cbarnhardt/SolarHarvestGPS/SolarHarvestGPS/20210426_162232.jpg

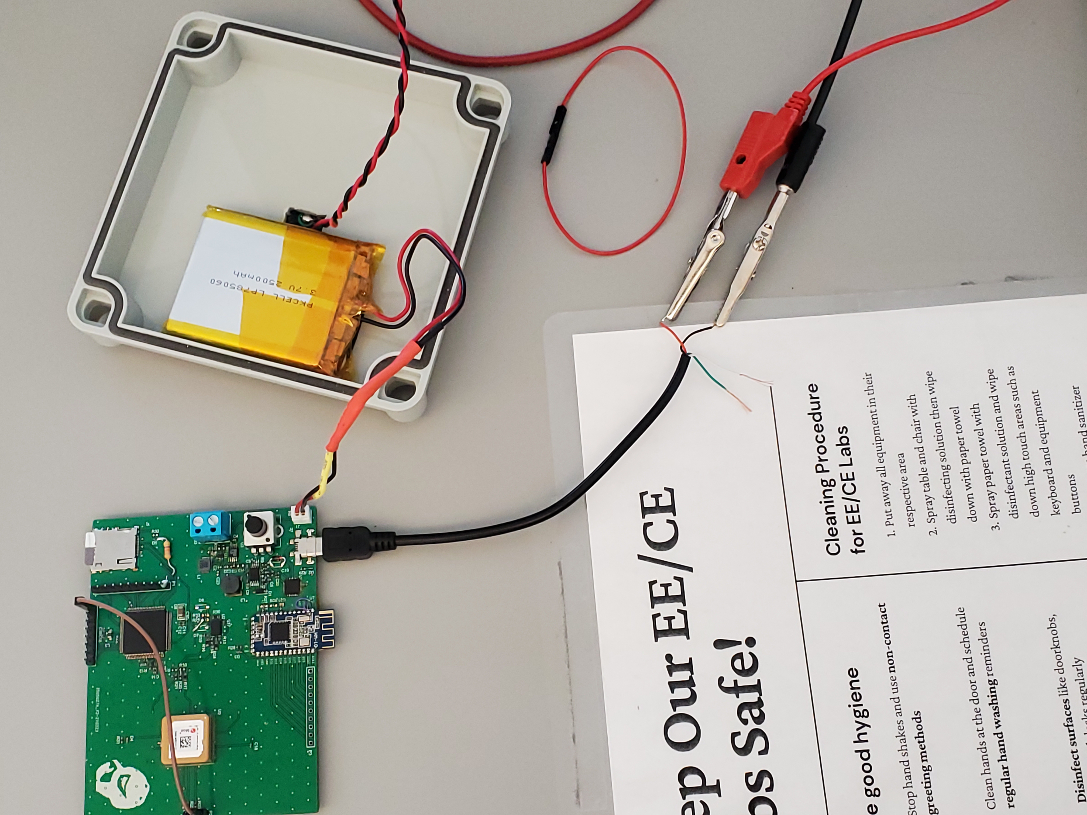
SolarHarvestGPS/20210426_162232.jpg
