cbarnhardt/SolarHarvestGPS/SolarHarvestGPS/20210426_161814.jpg

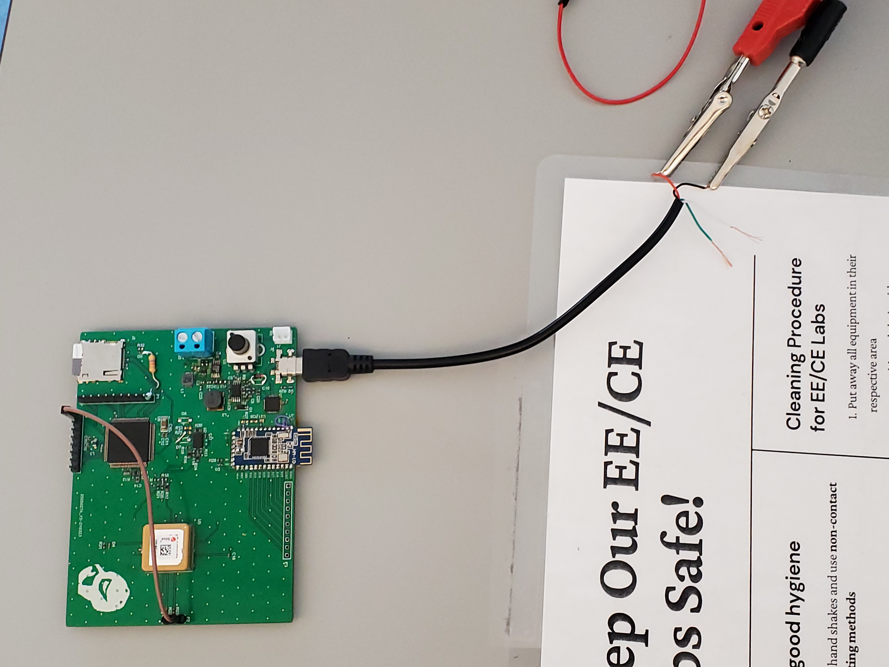
SolarHarvestGPS/20210426_161814.jpg
