cbarnhardt/SolarHarvestGPS/README.md

# SolarHarvestGPS
Project for embedded systems design course
Includes code and Altium files for the project. There is a portion of the report included to 
clarify what the project is and explain what it does. The devices used were a TI-MSP432 and
a SAM-M8Q along with various other peripherals.
