cbarnhardt/SolarHarvestGPS/SolarHarvestGPS/GPSBoardSourceFiles/GPS_Tracker_Logger.xls

Designator | Description | Value | Manufacturer | Manufacturer P/N | Vendor | Vendor P/N | Price | Quantity
BT1 | Adafruit Accessories Lithium Ion Polymer Battery 3.7V 2500mAh | - | Adafruit | 328 | Mouser | 485-328 | $14.95 | 0
C1 | Capacitor X6S 0402 (1005 Metric) | 22uF | Samsung Electro-Mechanics | GRM155R60J106ME05J | Mouser | 187-CL05A226MQ5N6J8 | $0.52 | 1
C2, C3, C4, C5, C6, C7, C22, C23 | Capacitor X6S 0402 (1005 Metric) | 10uF | Murata Electronics | GRM155R60J106ME05J | Mouser | 81-GRM155R60J106ME05 | $0.15 | 8
C8, C18, C20 | Capacitor X6S 0402 (1005 Metric) | 1uF | Murata Electronics | GRM155R70J105KA12J | Mouser | 81-GRM155R70J105KA2J | $0.11 | 3
C9, C11, C12, C13, C14, C15, C17, C19 | Capacitor X6S 0402 (1005 Metric) | 0.1uF | Murata Electronics | GRM155R71H104KE14D | Mouser | 81-GRM155R71H104KE4D | $0.10 | 8
C10 | 1206 Polarized Chip Capacitor - Standard | 10uF |  |  |  |  |  | 1
C16 | Capacitor X6S 0402 (1005 Metric) | 4.7uF | TDK | C1005X5R0J475K050BE | Mouser | 810-C1005X5R0J475KE | $0.43 | 1
C21 | Capacitor X7R 0402 (1005 Metric) | 0.1uF | AVX | 0402YC104JAT2A | Mouser | 581-0402YC104JAT2A | $0.72 | 1
D1, D6, D7, D8 | Schottky Diodes & Rectifiers REC SPCL SKTKY |  | ON Semiconductor | SBR80520LT1G | Mouser | 863-SBR80520LT1G | $0.43 | 4
D2, D5 | Standard LEDs - SMD 0201 SMD LEDs 520nm Green |  | Lumex | SML-LX0201UPGC-TR | Mouser | 696-SMLLX0201UPGCTR | $0.47 | 2
D3, D4 | BLUE - Standard LEDs - SMD 1.0X0.5MM |  | Kingbright | APHHS1005LQBC/D-V | Mouser | 604-APHHS1005LQBC/DV | $0.56 | 2
J1 | Connector Header Through Hole 2 position 0.079" (2.00mm) |  | JST Sales America Inc. | B2B-PH-K-S(LF)(SN) | Digikey Corp | 455-1704-ND | $0.17 | 1
J3 | Fixed Terminal Blocks Terminal block, screw type, 5.00, horizontal, 2 poles, CUI Blue, slotted screw, PCB mount |  | CUI Devices | TB001-500-02BE | Mouser | 490-TB001-500-02BE | $0.58 | 1
J4 | USB Connectors USB 2.0 micro B jack 5 pin HZ mid-mnt SMT |  | CUI Devices |  | Mouser | 490-UJ2-MIBH-4-MSMT | $1.05 | 1
J5 | Memory Card Connectors WR-CRD_SMT_MicroSD_Push & Push - SW closes to ground |  | Würth Elektronik | 693071030811 | Mouser | 710-693071030811 | $3.76 | 1
L1 | Shieled Power Inductor | 1uH | Wurth Elektronik | 74437324010 | Mouser | 710-74437324010 | 2.2 | 1
L2 | Fixed Inductors 10uH 56.4mOhms3.1A +/-20% 6.3x6.3x4.5mm | 10 uH | Murata Electronics | 1255AY-100M=P3 | Mouser | 81-1255AY-100MP3 | $0.47 | 1
L3 | Fixed Inductors 0805 4.7uH +/-30% 30MHz 0.8A 0.23ohms | 4.7uH | Murata Electronics | LQM21PN4R7NGRD | Mouser | 81-LQM21PN4R7NGRDRD | $0.32 | 1
P1, P3 | Header, 10-Pin |  |  |  |  |  |  | 2
P2 | Header, 3-Pin |  |  |  |  |  |  | 1
P4 | Header, 8-Pin |  |  |  |  |  |  | 1
R1, R10 | Resistor, 0402 Package size | 100k | Vishay / Dale |  | Mouser | 71-RCS0402100KFKED | $0.12 | 2
R2 | Resistor, 0402 Package size | 10m | Panasonic |  | Mouser | 667-ERJ-2LWFR010X | $0.39 | 1
R3, R11, R16, R17, R24, R25, R26, R27, R30, R33 |  | 0 | Vishay / Dale, [NoValue] | CRCW06030000Z0EA | Mouser | 71-CRCW0603-0-E3, [NoValue] | $0.10, [NoValue] | 10
R4 | Resistor, 0402 Package size | 1M | Vishay / Dale |  | Mouser | 71-CRCW04021M00FKEDH | $0.14 | 1
R5, R6, R7 | Resistor, 0402 Package size | 1K | Vishay / Dale |  | Mouser | 71-CRCW04021K00FKEDH | $0.14 | 3
R8 | Potentiometers PANEL CONTROL - 9MM-ST-CA 100 kohms 15 mm | 100k | Bourns | PTV09A-4015U-A104 | Mouser | 652-PTV09A-4015UA104 | $0.79 | 1
R9 | Resistor, 0402 Package size | 422k | Panasonic |  | Mouser | 667-ERJ-2RKF4223X | $0.10 | 1
R12 |  | 91k | Vishay / Dale | TNPW060391K0BEEA | Mouser | 71-TNPW060391K0BEEA | $1.28 | 1
R13, R14, R15 | Resistor, 0402 Package size | 10k | Vishay / Dale |  | Mouser | 71-RCS040210K0FKED | $0.12 | 3
R18, R19 | Resistor, 0402 Package size | 2.2k | Panasonic |  | Mouser | 667-ERJ-PA2F2201X | $0.23 | 2
R20, R21 | Resistor, 0402 Package size | 22 | Panasonic |  | Mouser | 667-ERJ-PA2F22R0X | $0.22 | 2
R22, R23 | Resistor, 0402 Package size | 470 | Panasonic |  | Mouser | 667-ERJ-PA2F4700X | $0.23 | 2
R28, R29, R31, R32 | Resistor, 0402 Package size | 390 | Yageo |  | Mouser | 603-RC0402FR-07390RL | $0.10 | 4
U1 | Switching Voltage Regulators 5.5V,2A,Sync Step-Down Converter with 25A IQ and Output Discharge in QFN and SOT563 Packages |  | Monolithic Power Systems (MPS) | MP2152GQFU-33-P | Mouser | 946-MP2152GQFU-33-P | $1.45 | 1
U2 | Accelerometer X, Y, Z Axis ±2g, 4g, 8g, 16g 0.05Hz ~ 1.6kHz 14-LGA (3x5) |  | Analog Devices Inc. |  | Digikey Corps. | ADXL343BCCZ-RL7TR-ND | $3.10 | 1
U3 | Battery Management Li-Ion/Polymer Shunt Battery Charger System with Low Battery Disconnect |  | Analog Devices | LTC4071EMS8E#PBF | Mouser | 584-LTC4071EMS8E#PBF | 5.81 | 1
U4 | Switching Voltage Regulators Hi Eff Solar Charger MPPT 0.3V to 5.5V |  | STMicroelectronics | SPV1040TTR | Mouser | 511-SPV1040TTR | $3.16 | 1
U5 | SAM-M8Q RF Receiver Galileo, GLONASS, GPS 1.575GHz, 1.602GHz -165dBm 400kbps |  | U-Blox | SAM-M8Q-0-10 | Digikey Corp. | 672-1054-2-ND | $25.00 | 1
U6 | USB Bridge, USB to UART USB 2.0 UART Interface 28-QFN (5x5) |  | Silicon Labs | CP2102-GMR | LCSC Electronics | C6568 | $2.36 | 1
U7 | BLE Communication module, send/receive communications via UART |  | DSD Tech | HM-10 | Amazon | HM-10 | $7.99 | 1
U8 | ARM® Cortex®-M4F MSP432™ Microcontroller IC 32-Bit 48MHz 256KB (256K x 8) FLASH 100-LQFP (14x14) |  | Texas Instruments |  | Digikey Corp. | 296-46884-ND | $9.32 | 1
