cbarnhardt/SolarHarvestGPS/SolarHarvestGPS/GPSBoardSourceFiles/Source.PDF

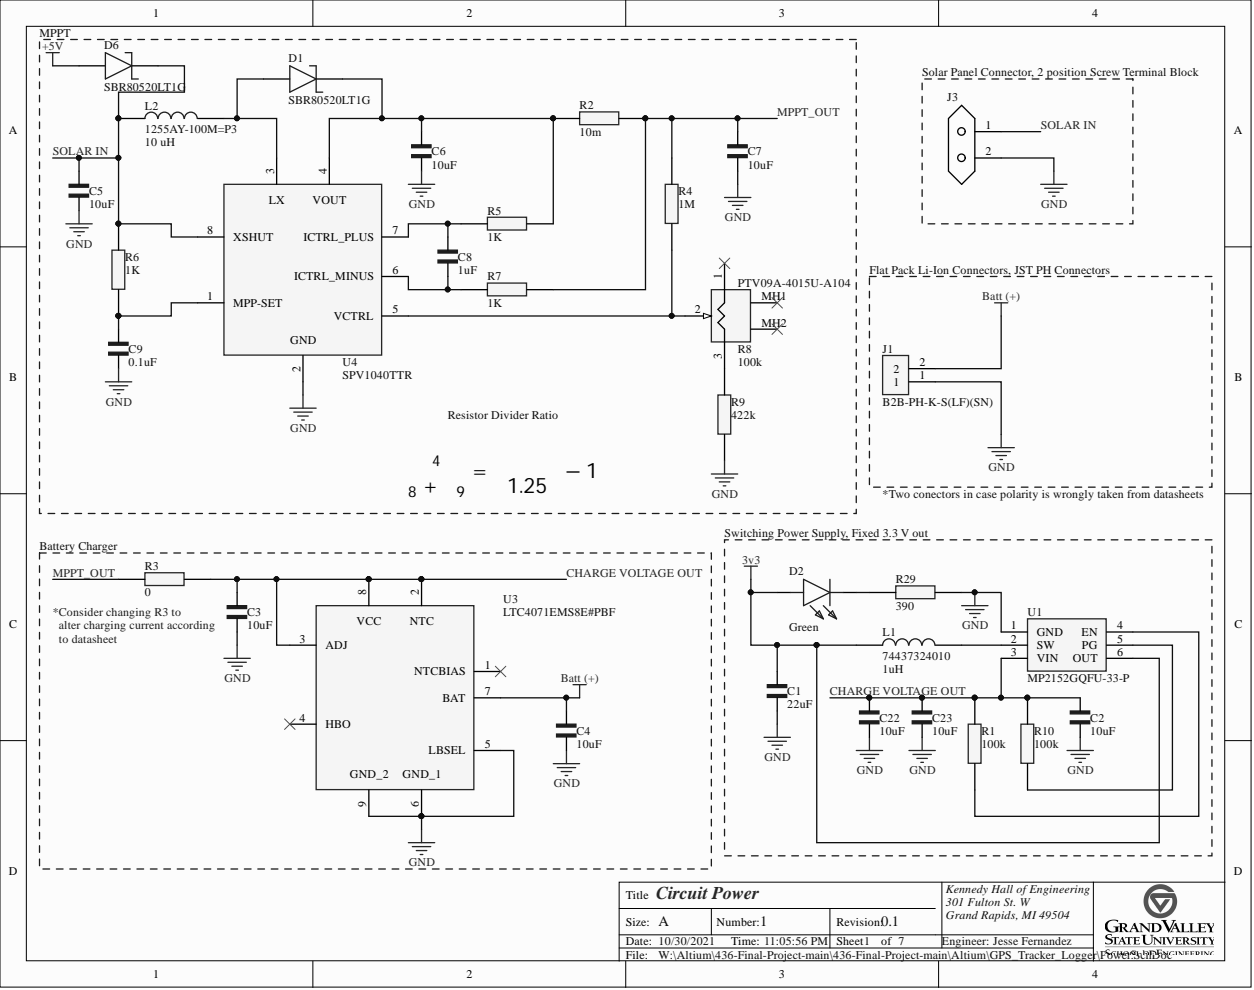
[picture p4: page 1]

Solar Panel Connector, 2 position Screw Terminal Block

Flat Pack Li-Ion Connectors, JST PH Connectors

*Two conectors in case polarity is wrongly taken from datasheets

Switching Power Supply, Fixed 3.3 V out

*Consider changing R3 to
alter charging current according
to datasheet

Circuit Power Title | Kennedy Hall of Engineering 301 Fulton St. W Grand Rapids, MI 49504

Size: A | Number: 1 | Revision: 0.1
Date: 10/30/2021 Time: 11:05:56 PM | Sheet of | Engineer: Jesse Fernandez

W:\Altium\436-Final-Project-main\436-Final-Project-main\Altium\GPS_Tracker_Logger\Power.SchDoc

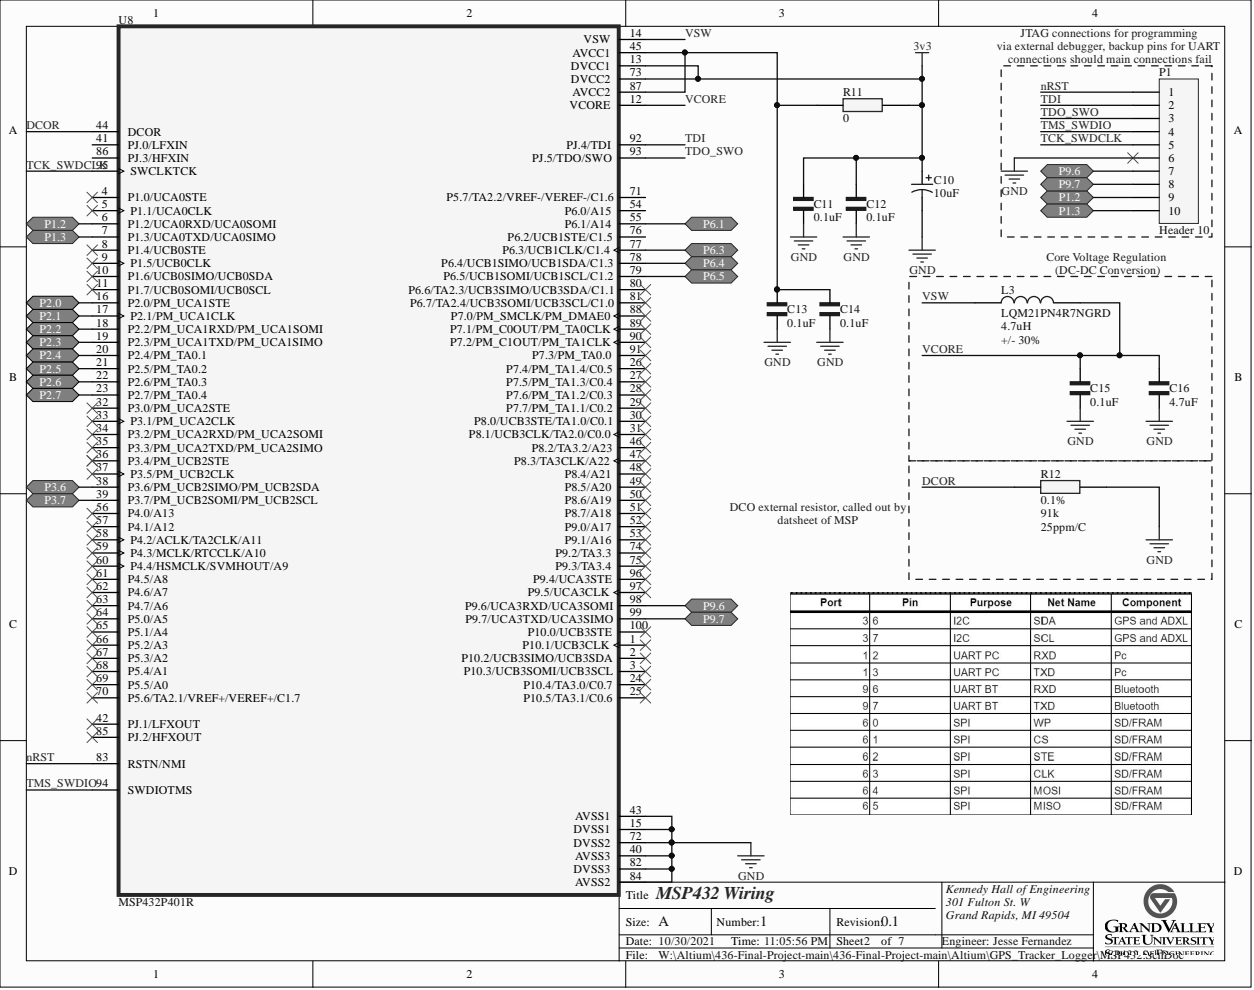
[picture p5: page 2]

MSP43 2 T i t l e | Ken nedy Ha l l of E n g i neer i n g 3 0 1 F u l t o n S t. W G r a n d R ap i d s, MI 4

Size: | N umber: | Rev i s i o n : 0.1

/ / T ime: : : 6 PM | Sheet o f | E n g i neer: Jes se Fernan dez

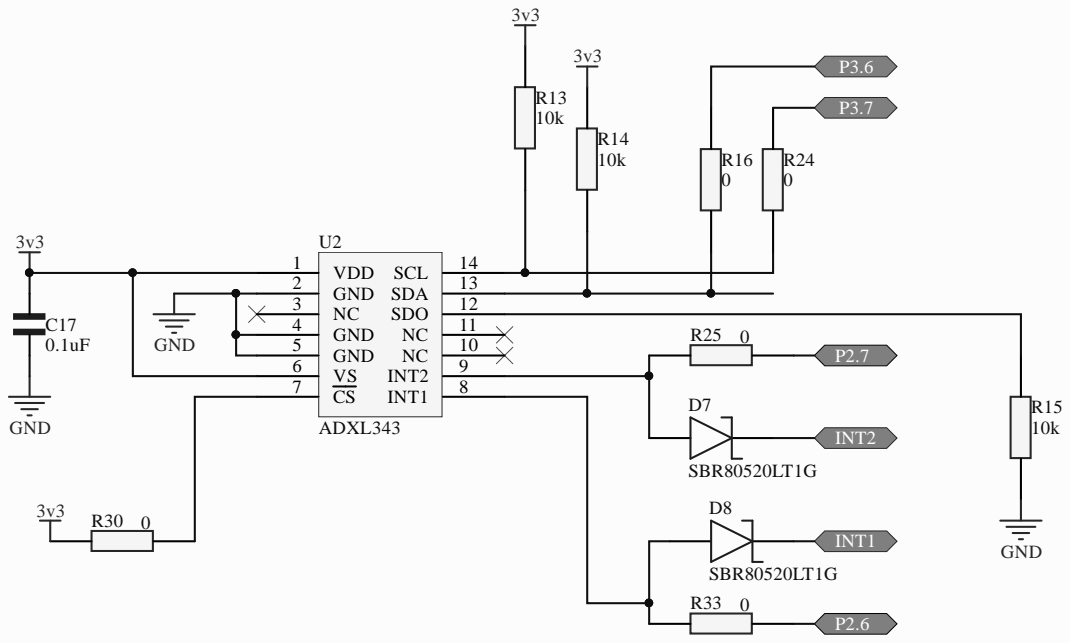
[picture p6: page 3]

4 | | 1 | R2 5 0

6 | | 8 INT2 9 NC 1

ADXL3 43 T i t l e | Ken nedy Ha l l of E n g i neer i n g 3 0 1 F u l t o n S t. W G r a n d R ap i d s, MI 4

Size: | N umber: | Rev i s i o n : 0.1

/ / T ime: : : 6 PM | Sheet o f | E n g i neer: Jes se Fernan dez

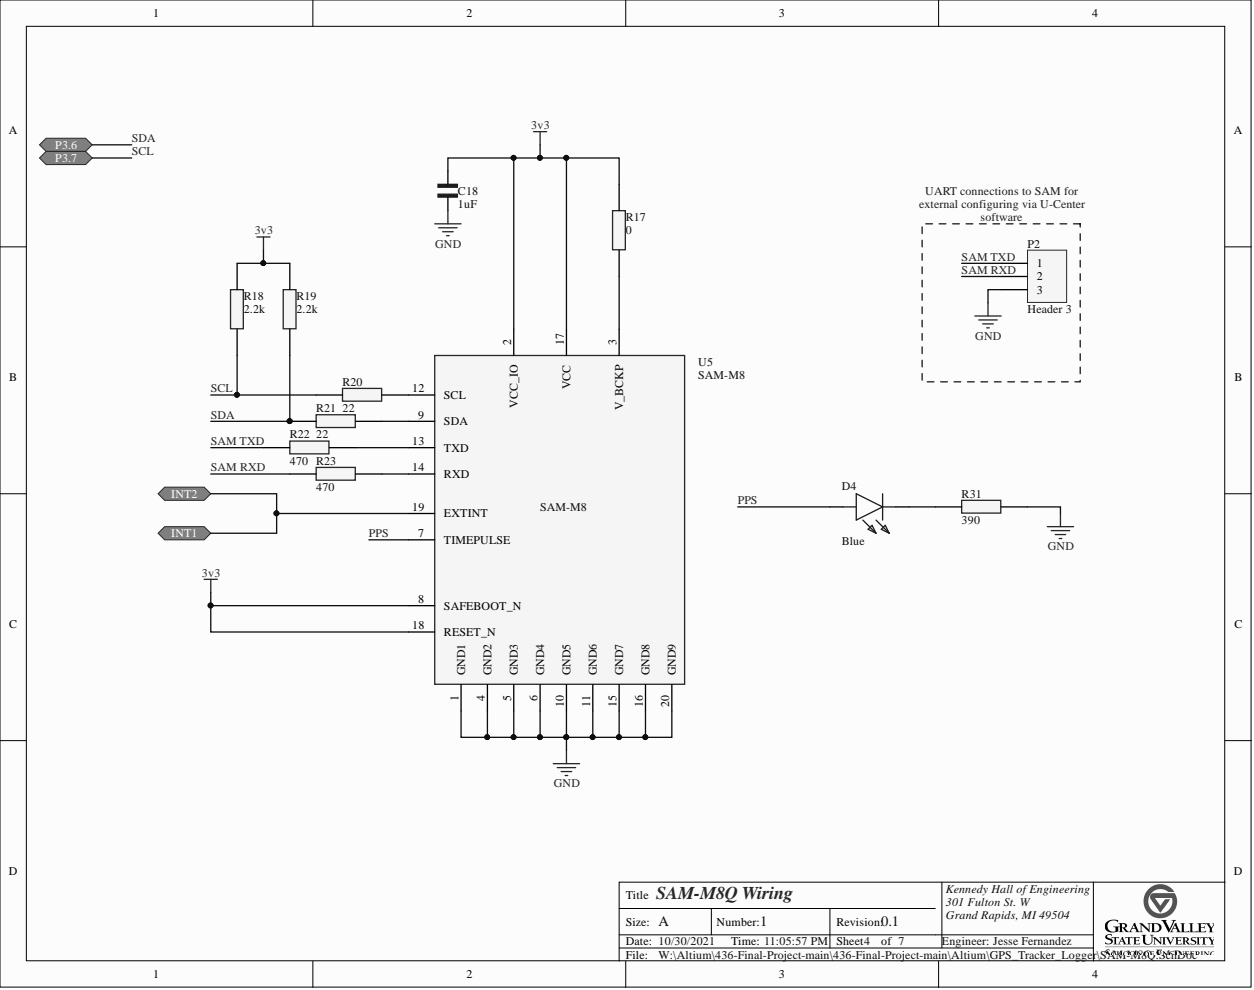
[picture p7: page 4]

UART connections to SAM for
external configuring via U-Center

Kennedy Hall of Engineering
301 Fulton St. W

W:\Altium\436-Final-Project-main\436-Final-Project-main\Altium\GPS_Tracker_Logger\SAM-M8Q.SchDoc

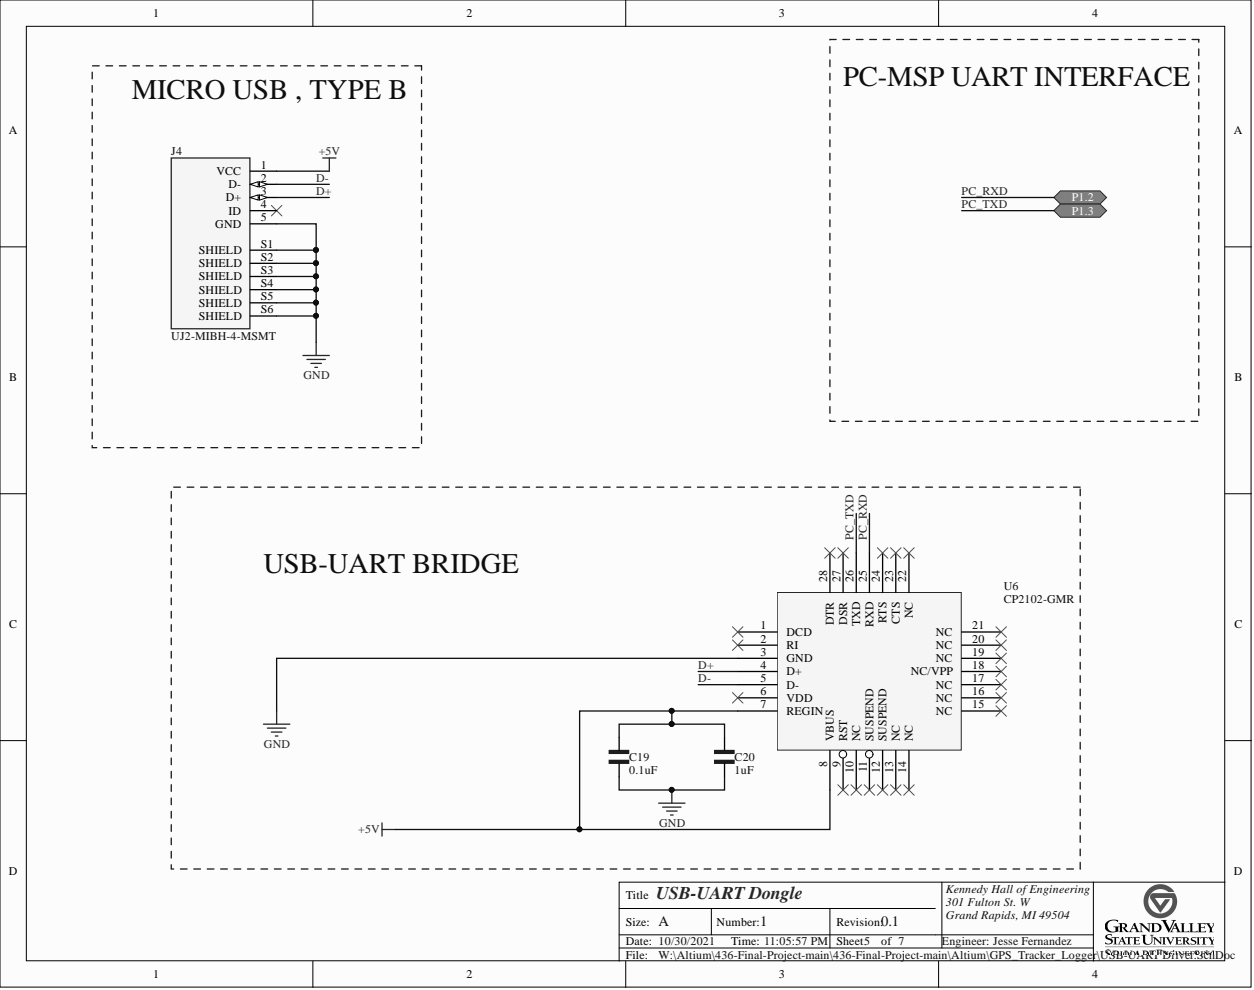
[picture p8: page 5]

NC 22 CTS 23 RTS 24 RXD 25 TXD 26 DSR 27 DTR 28

Kennedy Hall of Engineering
301 Fulton St. W

W:\Altium\436-Final-Project-main\436-Final-Project-main\Altium\GPS_Tracker_Logger\USB-UART Driver.SchDoc

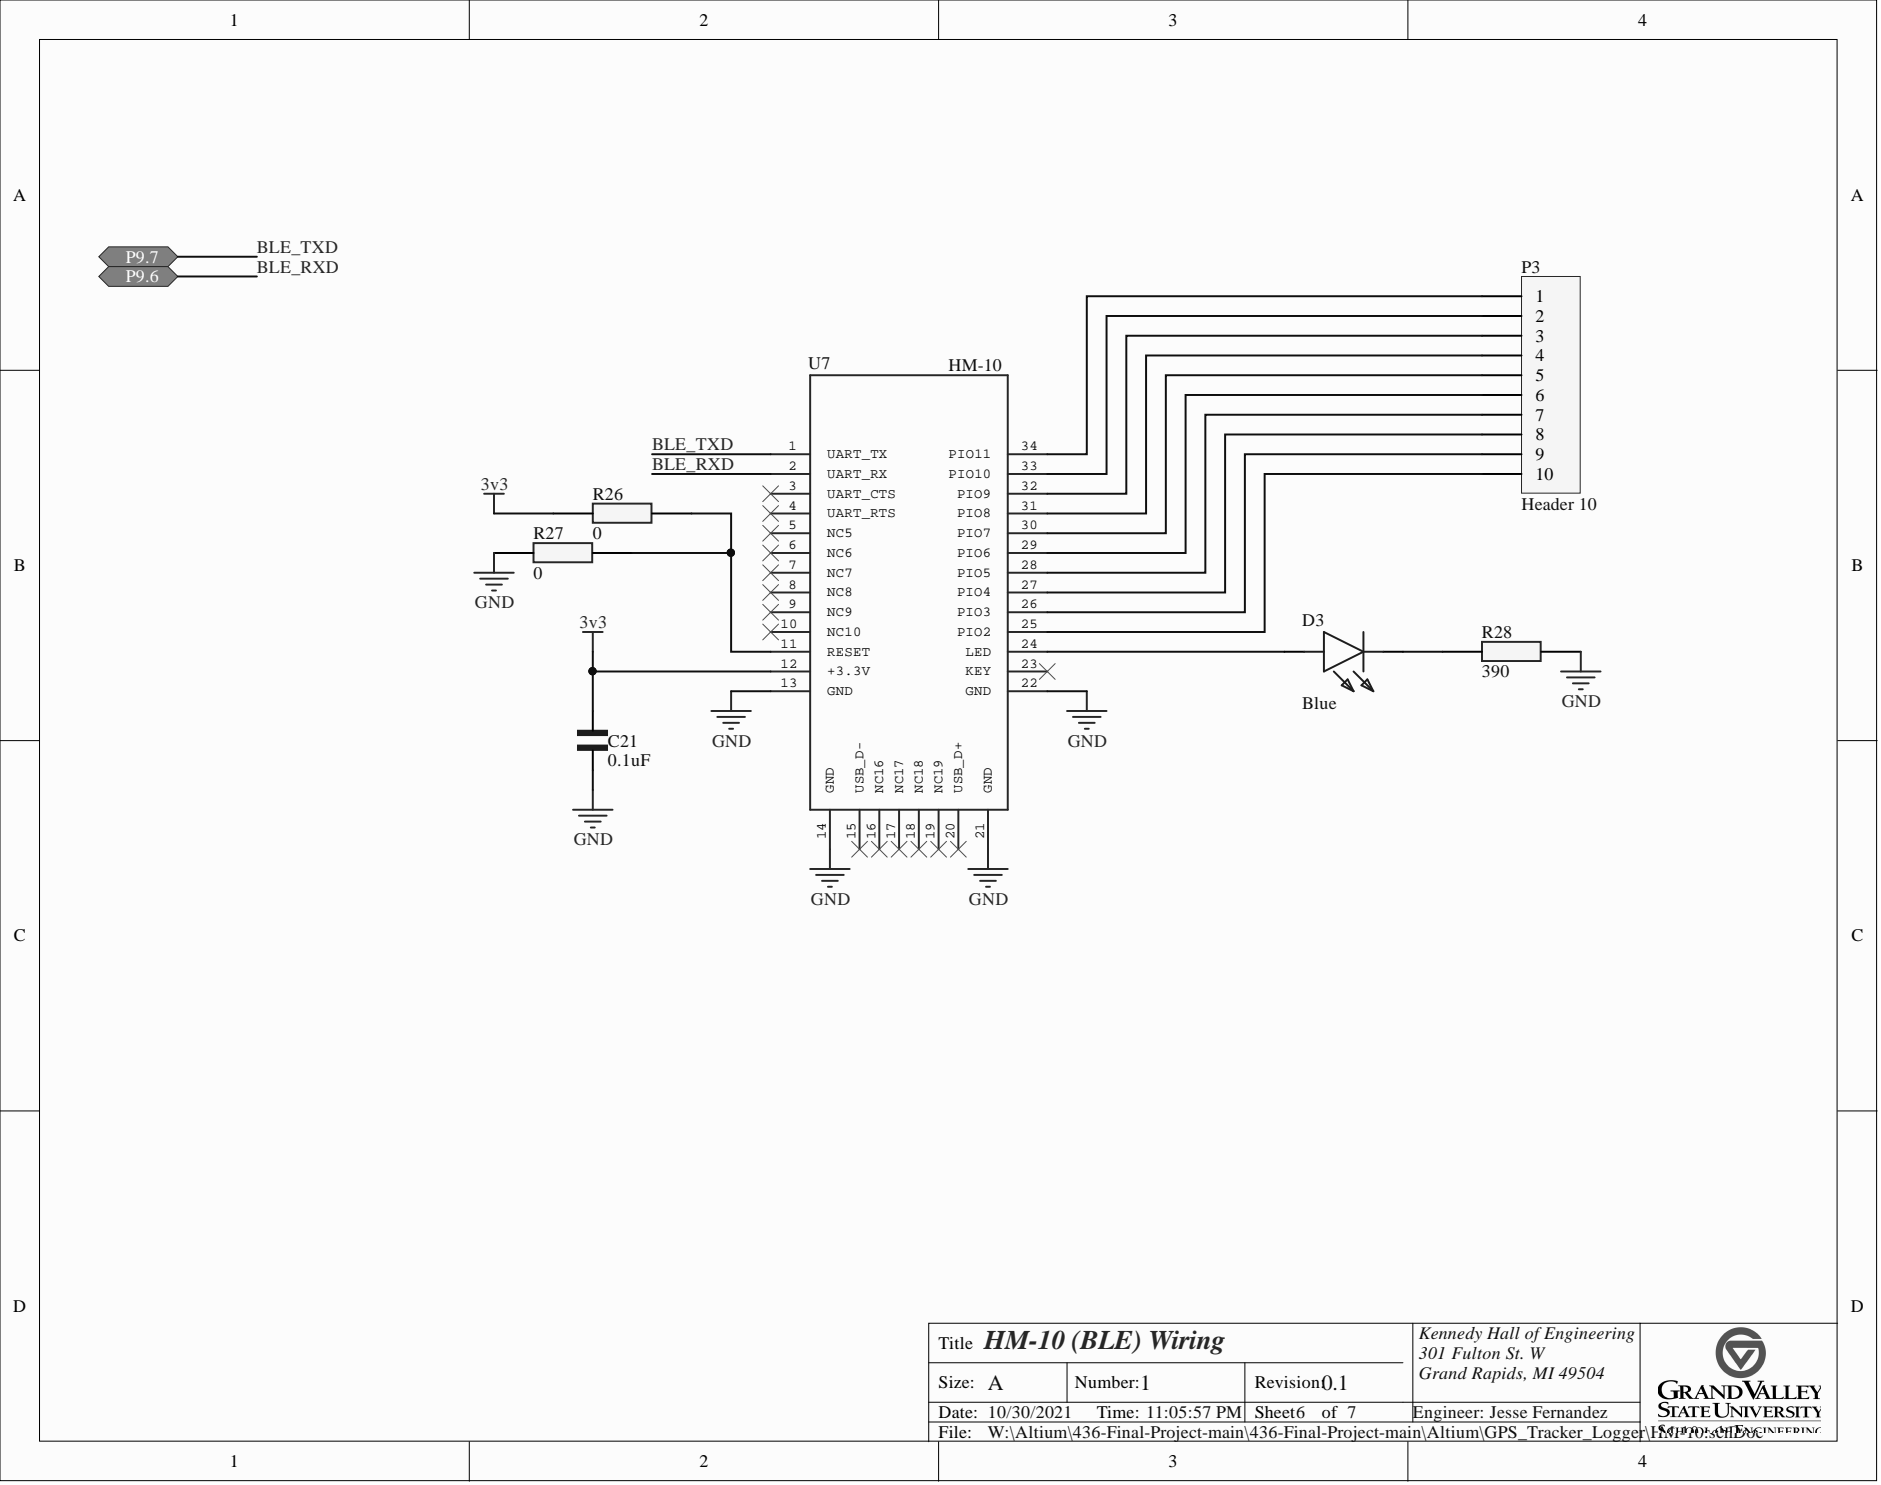
[picture p9: page 6]

3 3
3 2
3 1

5 | | 3 0
6 | | 2 9
7 | | 2 8
8 | | 2 7
9 | | 2 6
1 0 | | 2 5 | D 3

1 1 | | 2 4
1 2 | | 2 3

HM-1 0 (BLE) Wiring T i t l e | Ken nedy Ha l l of E n g i neer i n g 3 0 1 F u l t o n S t. W G r a n d R ap i d s, MI 4

Size: | N umber: | Rev i s i o n : 0.1

/ / T ime: : : 7 PM | Sheet o f | E n g i neer: Jes se Fernan dez

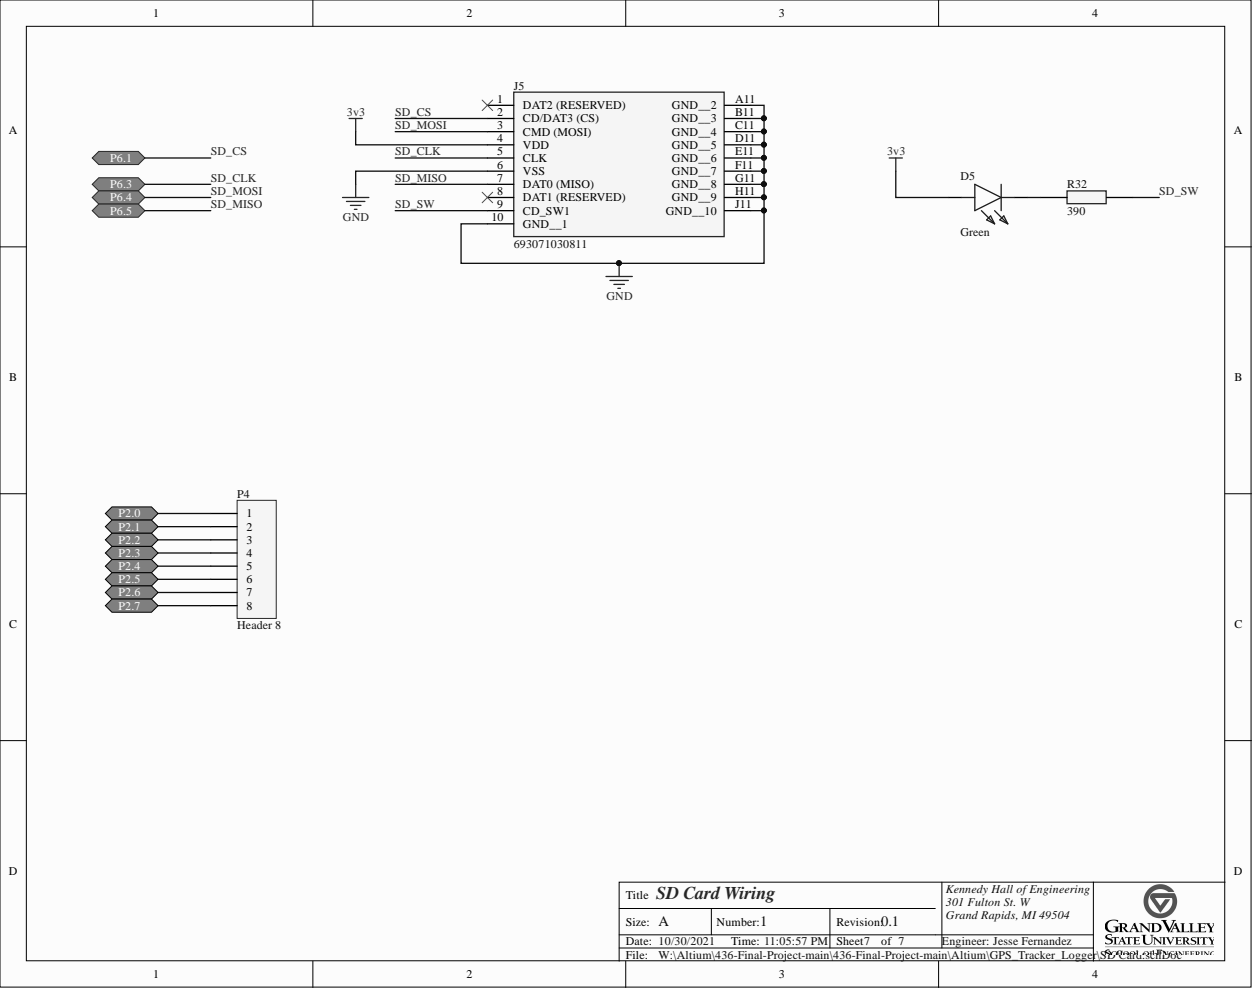
[picture p10: page 7]

Kennedy Hall of Engineering
301 Fulton St. W

W:\Altium\436-Final-Project-main\436-Final-Project-main\Altium\GPS_Tracker_Logger\SD Card.schDoc

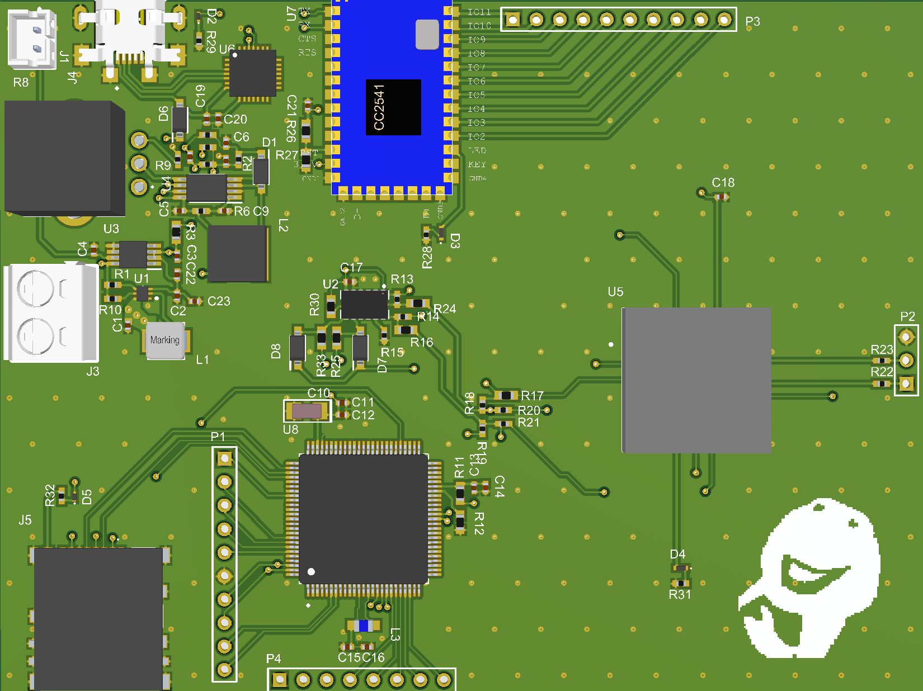
[picture p11: page 8]

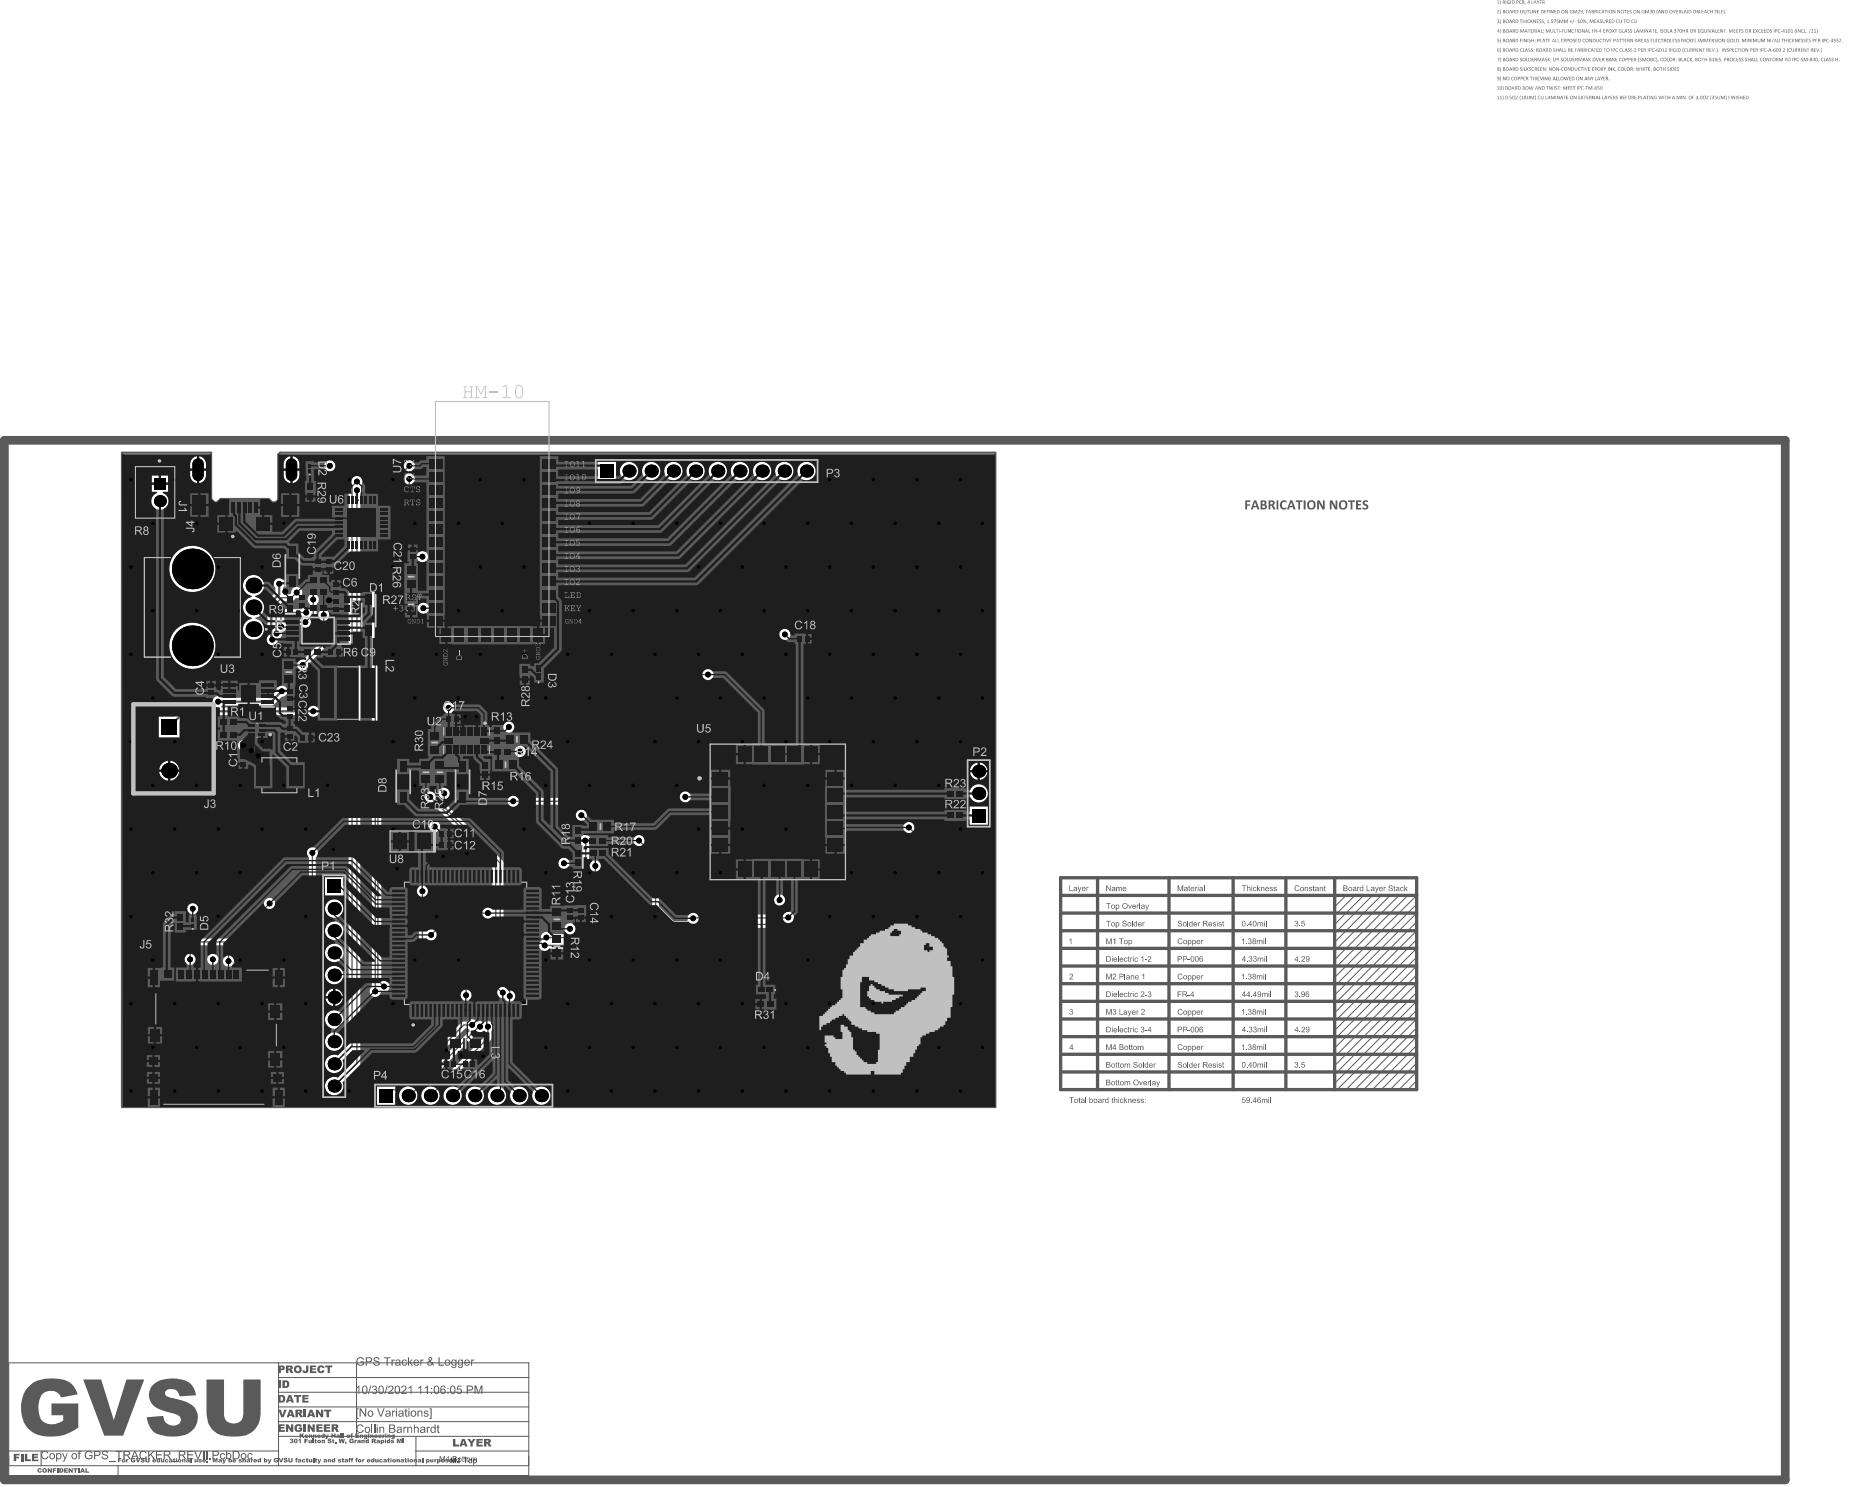
[picture p12: page 9]
