cbarnhardt/SolarHarvestGPS/(list of files, drawings)

Other design files:
SolarHarvestGPS/GPSBoardSourceFiles/Altium Files/ADXL 343.SchDoc
SolarHarvestGPS/GPSBoardSourceFiles/Altium Files/HM-10.schDoc
SolarHarvestGPS/GPSBoardSourceFiles/Altium Files/MSP432.SchDoc
SolarHarvestGPS/GPSBoardSourceFiles/Altium Files/Power.SchDoc
SolarHarvestGPS/GPSBoardSourceFiles/Altium Files/SD Card.schDoc
SolarHarvestGPS/GPSBoardSourceFiles/Altium Files/USB-UART Driver.SchDoc
