cbarnhardt/SolarHarvestGPS/SolarHarvestGPS/GPSBoardCodeSample/Timing.h

/*
 * Timing.h
 *
 *  Created on: Jan 23, 2021
 *      Author: jesse
 */

#ifndef TIMING_H_
#define TIMING_H_

#include <msp432.h>

void TIMING_TIMER_A_SETUP(void);
void ACTIVITY_TIMER_A_SETUP(void);

#endif /* TIMING_H_ */
