cbarnhardt/SolarHarvestGPS/SolarHarvestGPS/20210301_172134.jpg

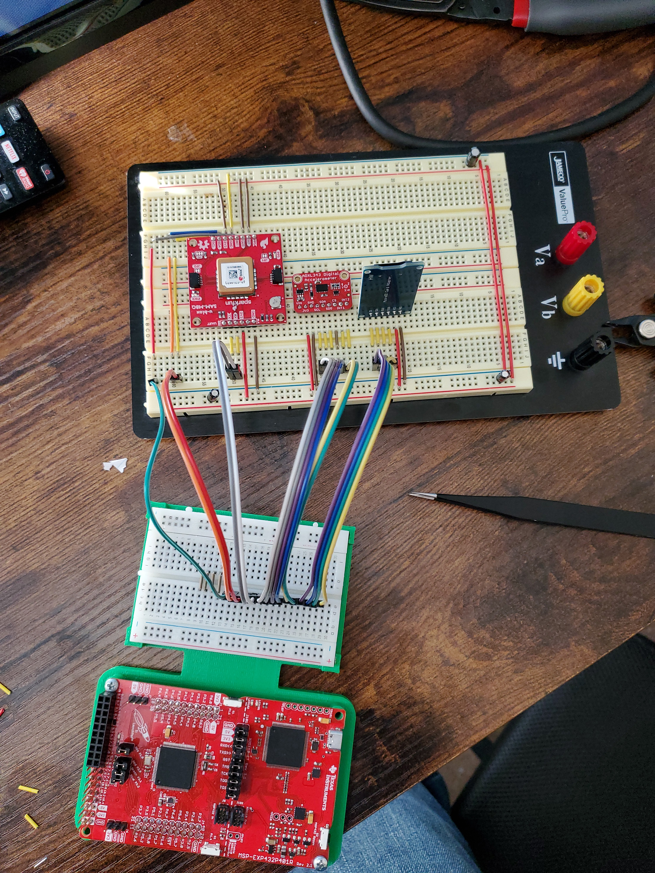
SolarHarvestGPS/20210301_172134.jpg
